TomaszDzieduszynski/super-bot-gears/diagrams/blink.jpg

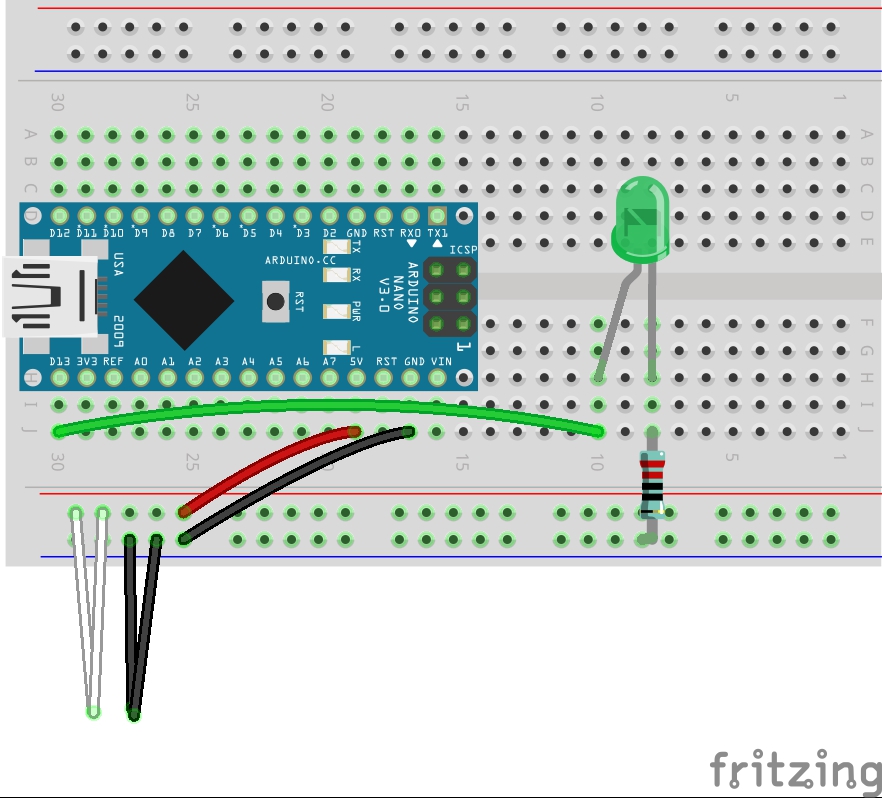
diagrams/blink.jpg
