TomaszDzieduszynski/super-bot-gears/diagrams/fade.jpg

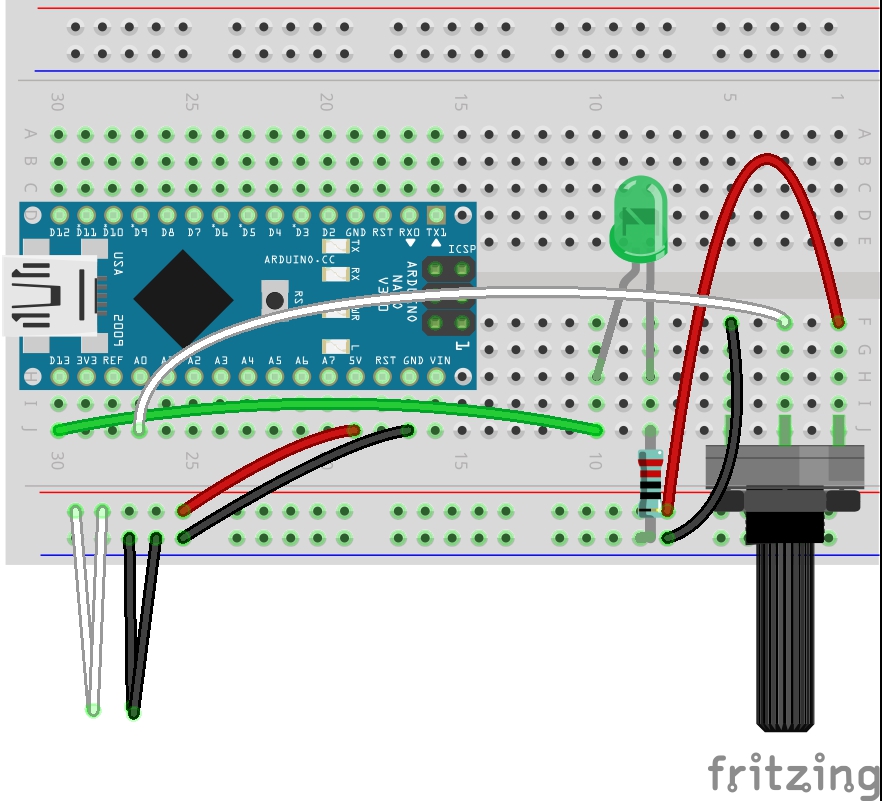
diagrams/fade.jpg
