TomaszDzieduszynski/super-bot-gears/diagrams/power_flower.jpg

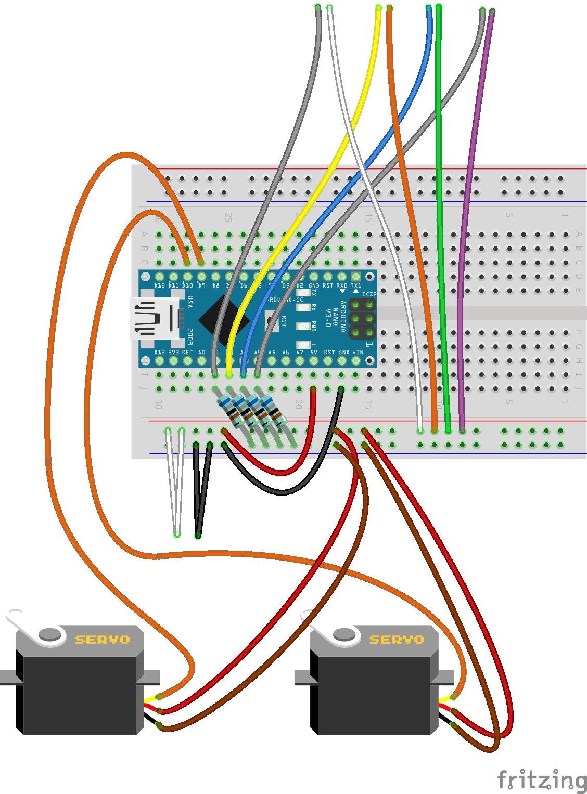
diagrams/power_flower.jpg
