TomaszDzieduszynski/super-bot-gears/diagrams/robo_arm.jpg

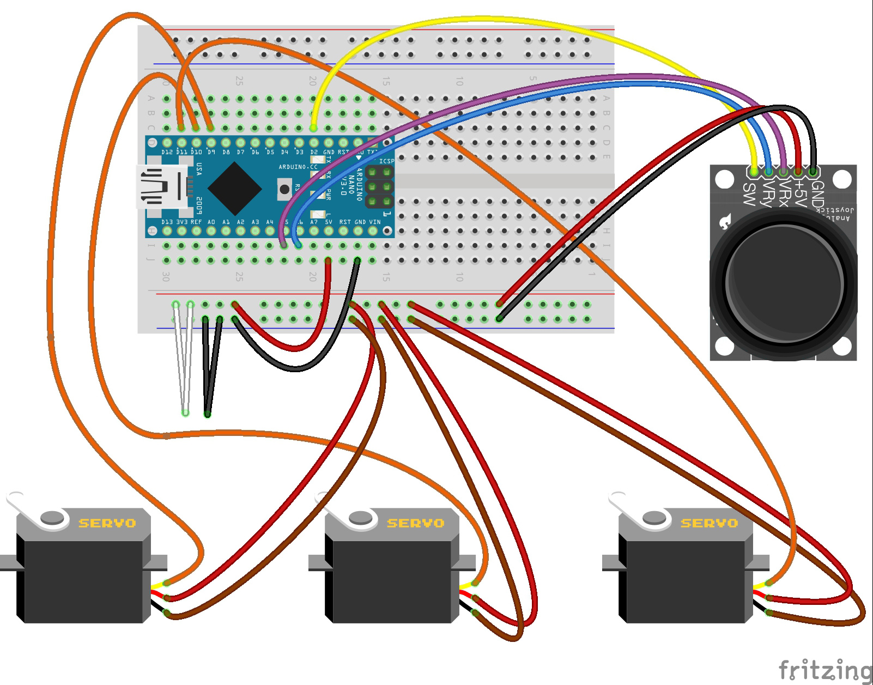
diagrams/robo_arm.jpg
