TomaszDzieduszynski/super-bot-gears/diagrams/wild_dragon.jpg

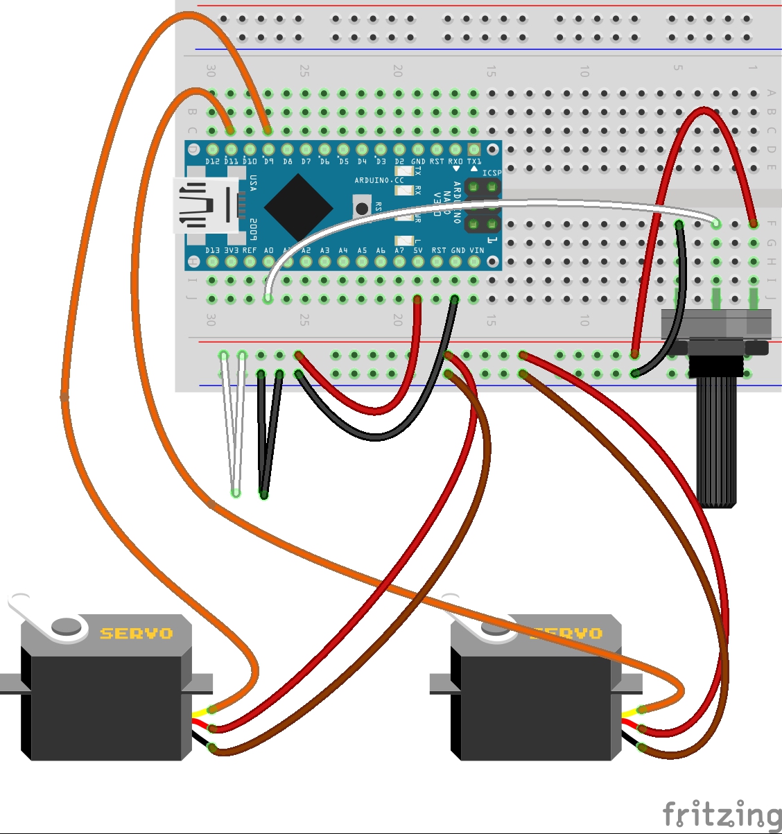
diagrams/wild_dragon.jpg
