TomaszDzieduszynski/super-bot-gears/docs/box_label_en.jpg

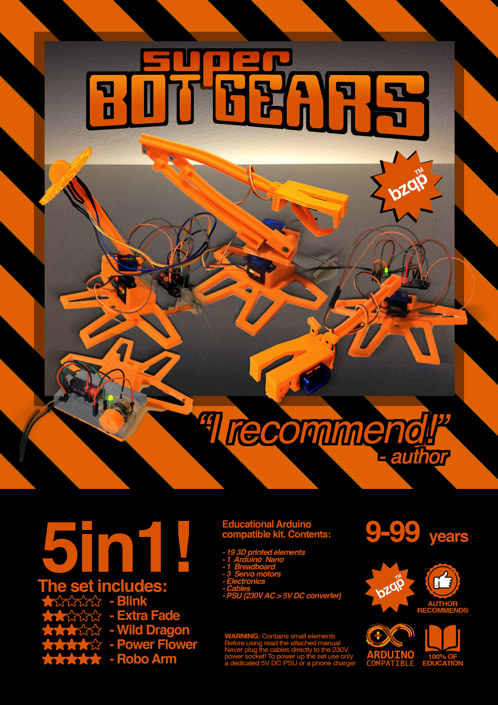
docs/box_label_en.jpg
