TomaszDzieduszynski/super-bot-gears/images/photo1.jpg

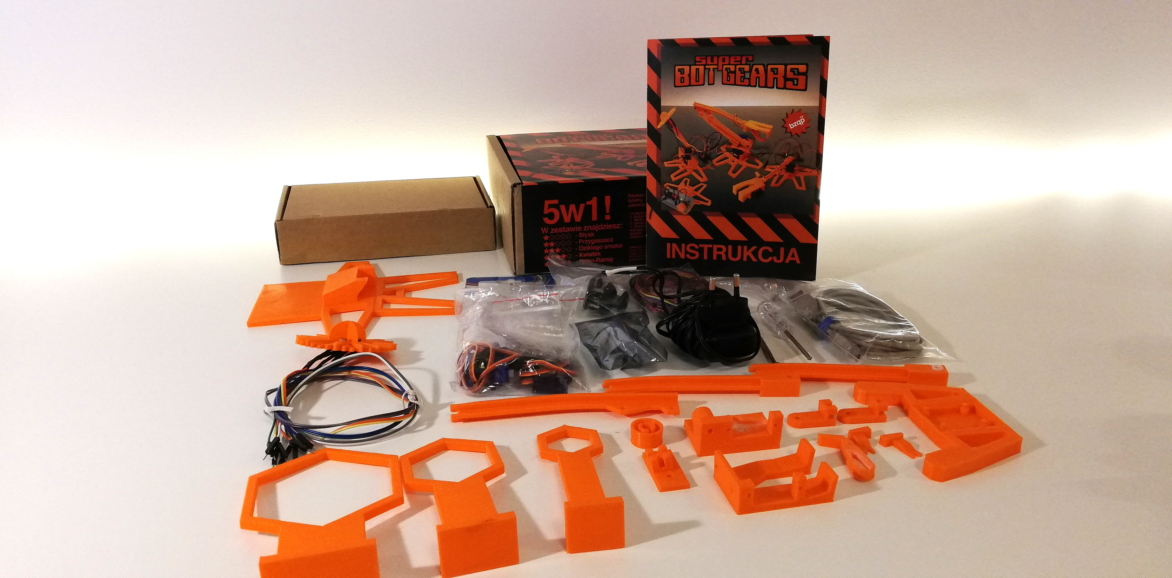
images/photo1.jpg
