TomaszDzieduszynski/super-bot-gears/images/photo2.jpg

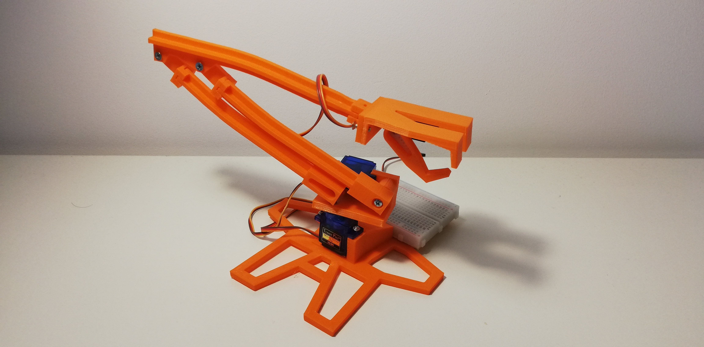
images/photo2.jpg
