TomaszDzieduszynski/super-bot-gears/stl/1x_claw.stl

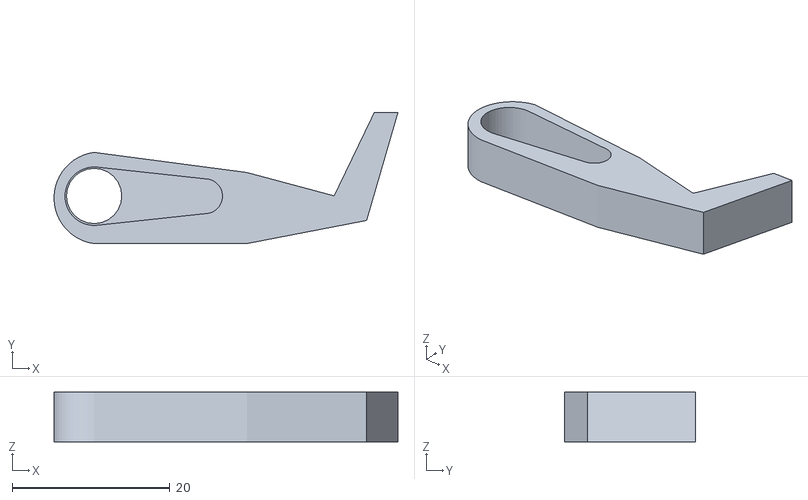
[picture p10: CAD file, 2026-10-31]
stl/1x_claw.stl
43.6 x 16.6 x 6.30
