TomaszDzieduszynski/super-bot-gears/stl/1x_joystick.stl

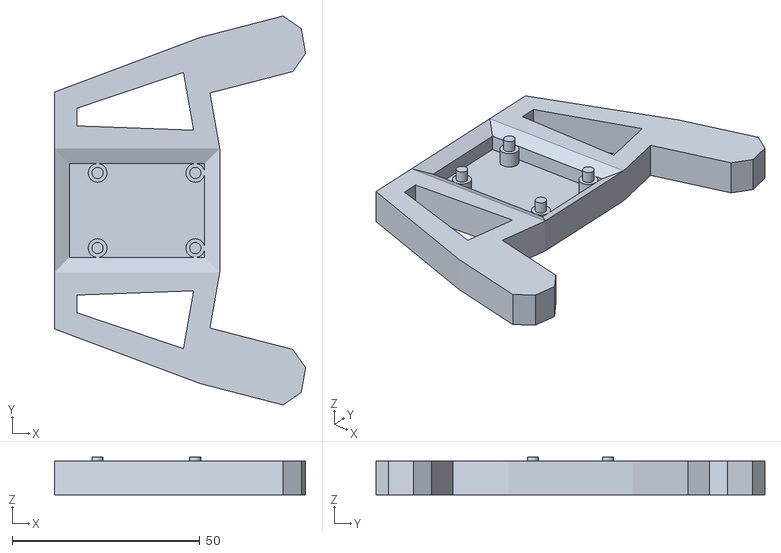
[picture p11: CAD file, 2026-10-31]
stl/1x_joystick.stl
66.8 x 103.5 x 10.0
