TomaszDzieduszynski/super-bot-gears/stl/1x_gripper.stl

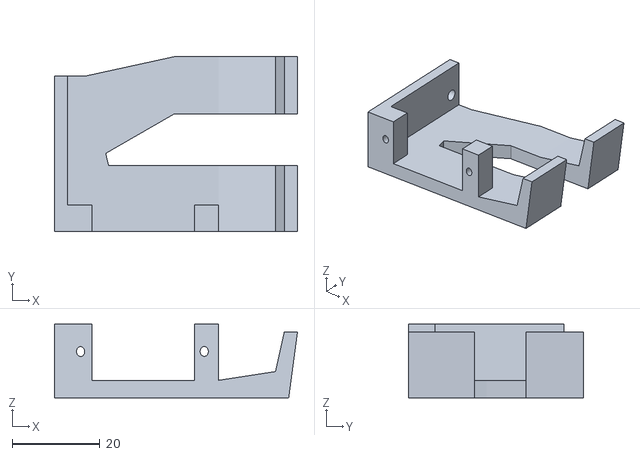
[picture p12: CAD file, 2026-10-31]
stl/1x_gripper.stl
55.2 x 39.7 x 16.8
