TomaszDzieduszynski/super-bot-gears/stl/1x_eyes.stl

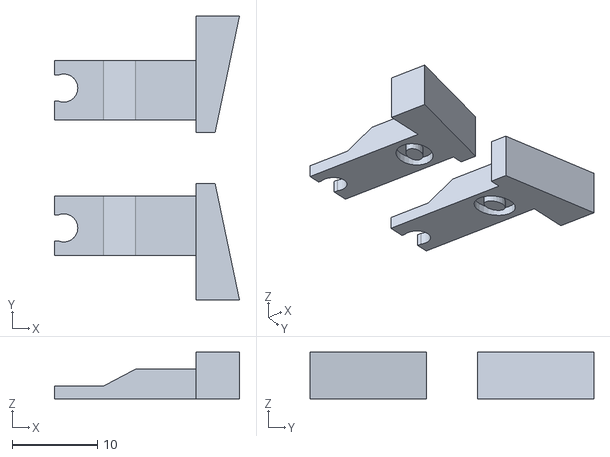
[picture p13: CAD file, 2026-10-31]
stl/1x_eyes.stl
21.7 x 33.2 x 5.50
