TomaszDzieduszynski/super-bot-gears/stl/2x_hinge.stl

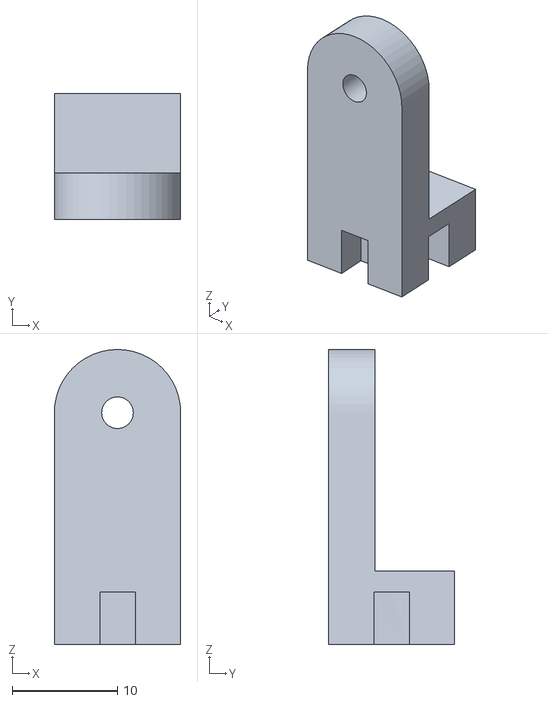
[picture p14: CAD file, 2026-10-31]
stl/2x_hinge.stl
12.0 x 12.0 x 28.0
