TomaszDzieduszynski/super-bot-gears/stl/1x_base_adapter.stl

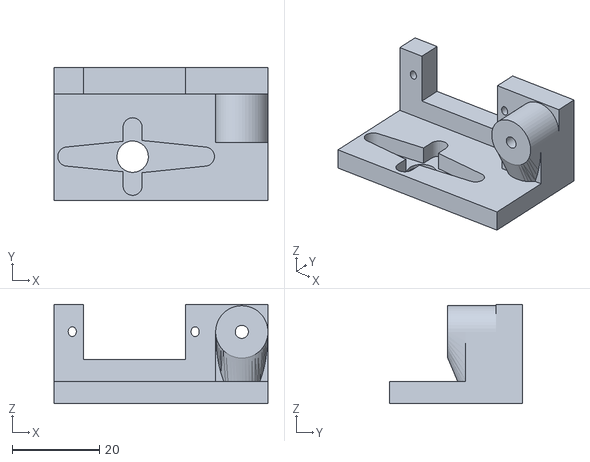
[picture p15: CAD file, 2026-10-31]
stl/1x_base_adapter.stl
49.0 x 30.4 x 22.7
