TomaszDzieduszynski/super-bot-gears/stl/1x_double_beam.stl

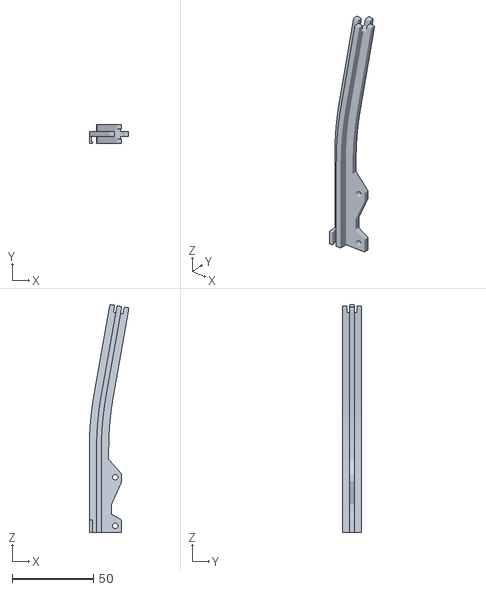
[picture p16: CAD file, 2026-10-31]
stl/1x_double_beam.stl
24.3 x 12.0 x 140.5
