TomaszDzieduszynski/super-bot-gears/stl/1x_loops.stl

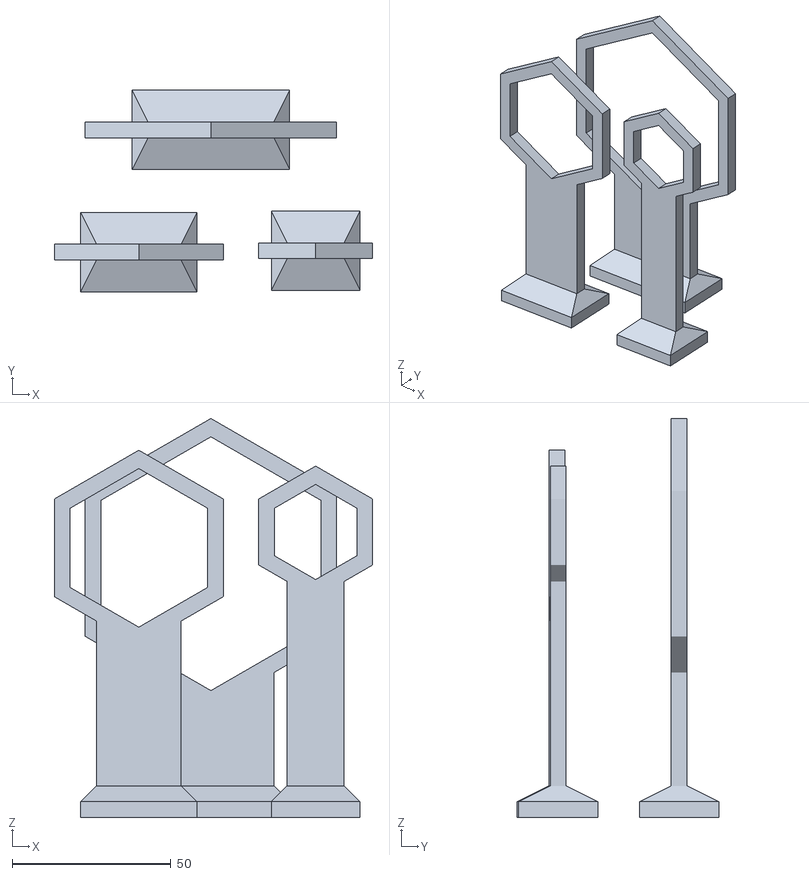
[picture p17: CAD file, 2026-10-31]
stl/1x_loops.stl
100.4 x 63.5 x 125.8
