TomaszDzieduszynski/super-bot-gears/stl/1x_flower.stl

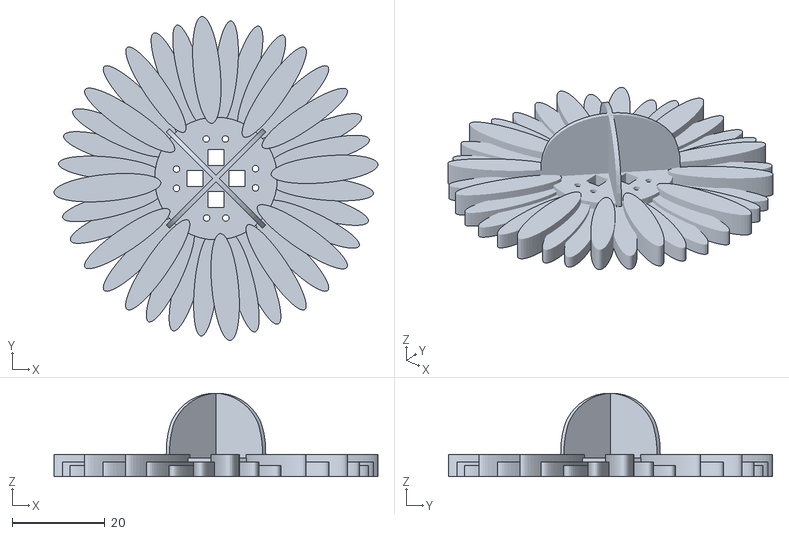
[picture p18: CAD file, 2026-10-31]
stl/1x_flower.stl
69.7 x 69.7 x 18.0
