TomaszDzieduszynski/super-bot-gears/stl/1x_base.stl

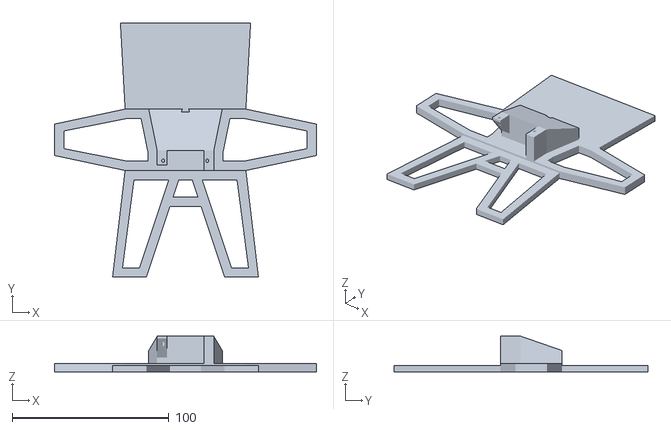
[picture p19: CAD file, 2026-10-31]
stl/1x_base.stl
167.0 x 162.1 x 22.7
