TomaszDzieduszynski/super-bot-gears/stl/1x_beam_free.stl

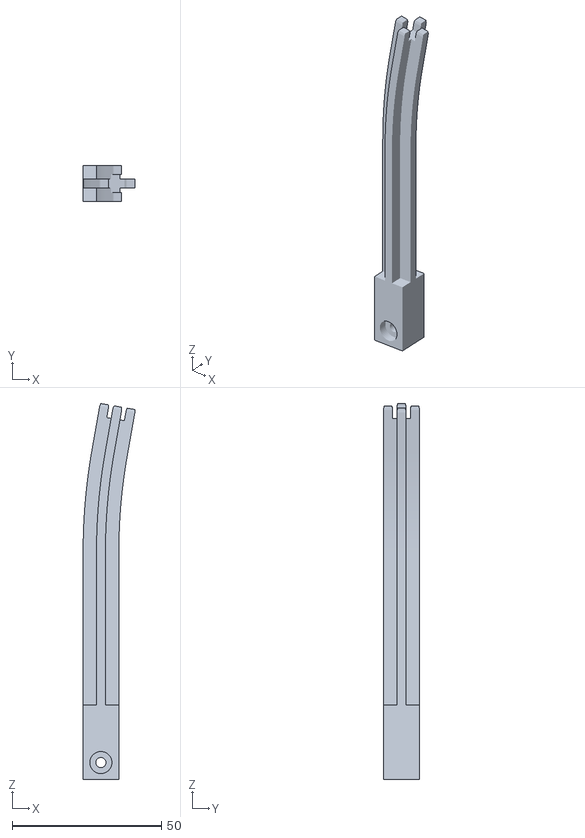
[picture p20: CAD file, 2026-10-31]
stl/1x_beam_free.stl
17.4 x 12.0 x 126.1
