TomaszDzieduszynski/super-bot-gears/stl/1x_beam_constrained.stl

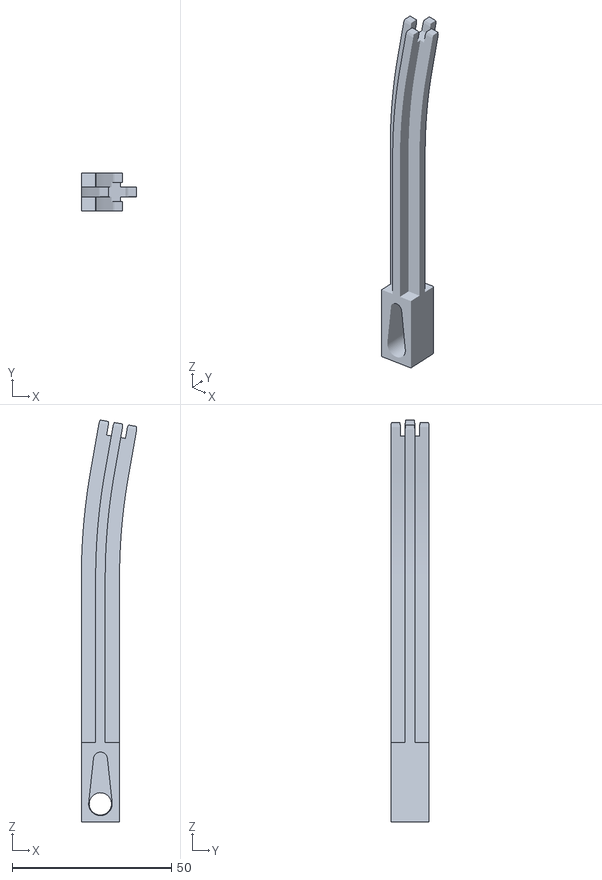
[picture p21: CAD file, 2026-10-31]
stl/1x_beam_constrained.stl
17.4 x 12.0 x 126.1
