TomaszDzieduszynski/super-bot-gears/stl/1x_knob.stl

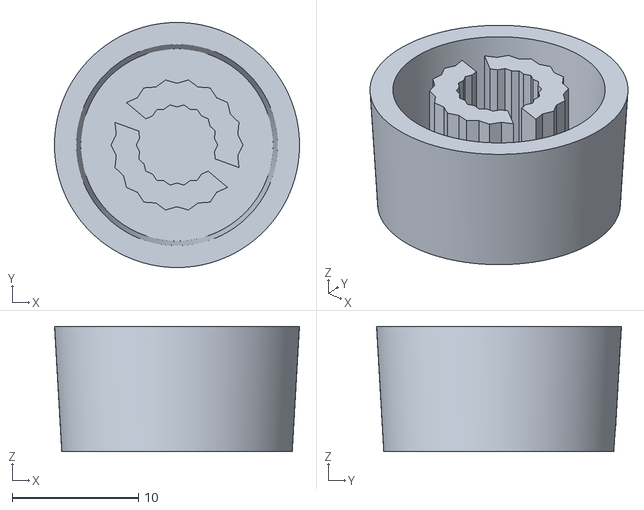
[picture p22: CAD file, 2026-10-31]
stl/1x_knob.stl
19.4 x 19.4 x 9.91
