TomaszDzieduszynski/super-bot-gears/stl/1x_gripper_adapter.stl

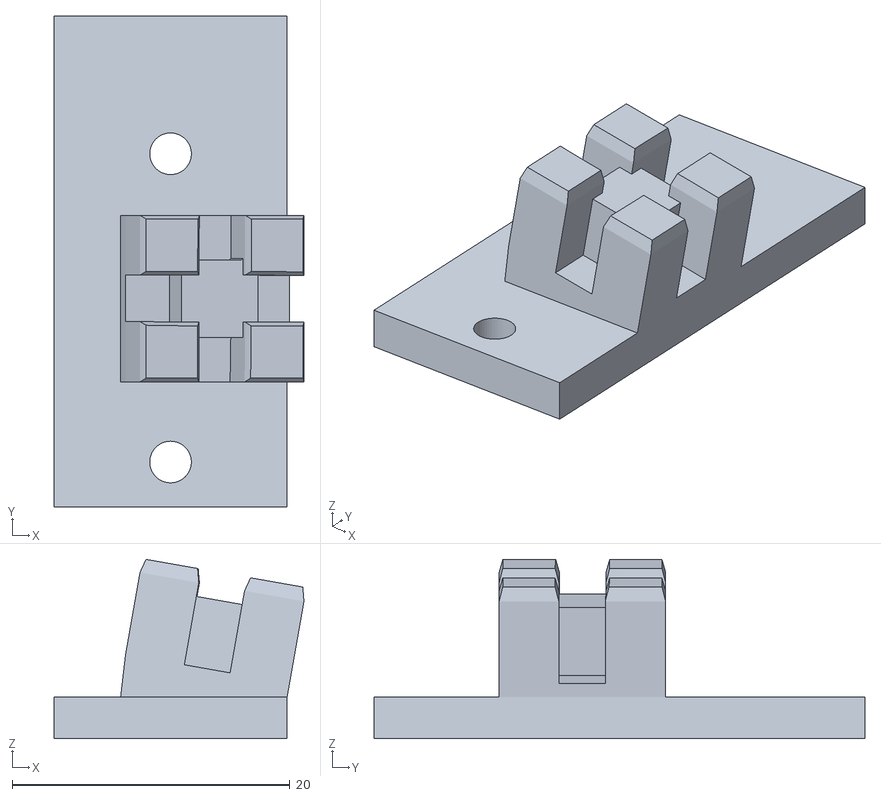
[picture p23: CAD file, 2026-10-31]
stl/1x_gripper_adapter.stl
18.0 x 35.4 x 12.9
