TomaszDzieduszynski/super-bot-gears/stl/6x_washer_(optional).stl

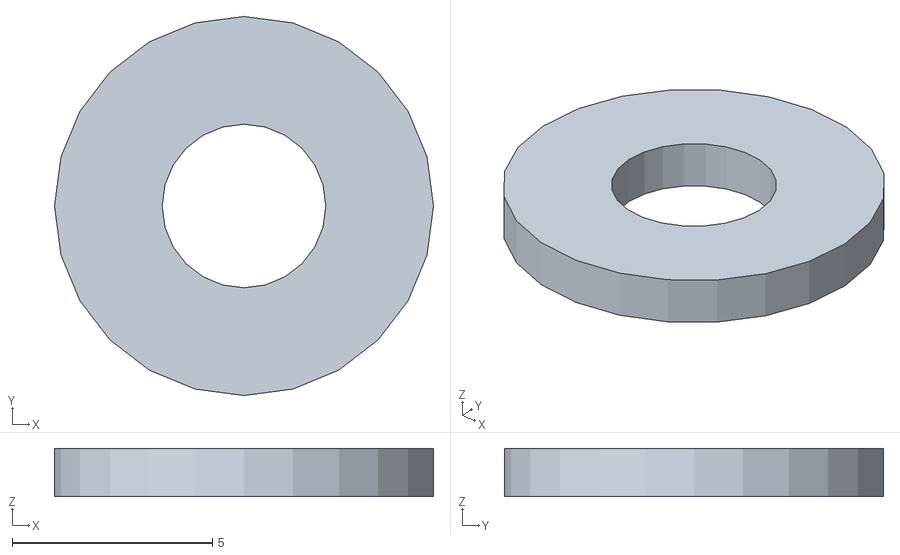
[picture p24: CAD file, 2026-10-31]
stl/6x_washer_(optional).stl
9.45 x 9.45 x 1.20
